hthouse/Robot_Getafix/media/roboeye1.gif

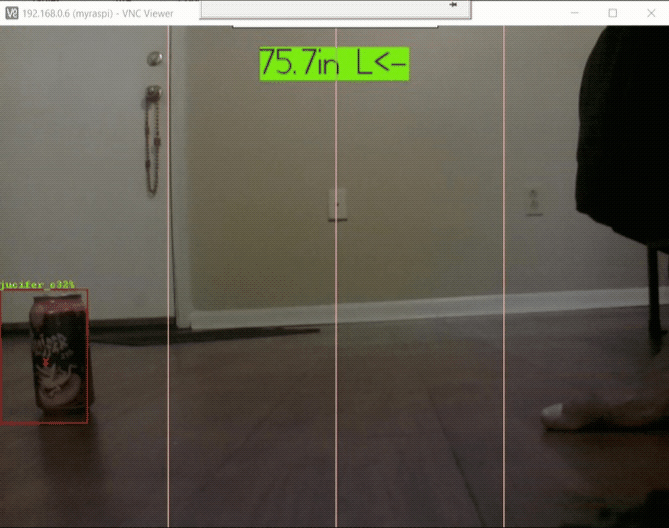
media/roboeye1.gif
