hthouse/Robot_Getafix/media/robopic1.jpg

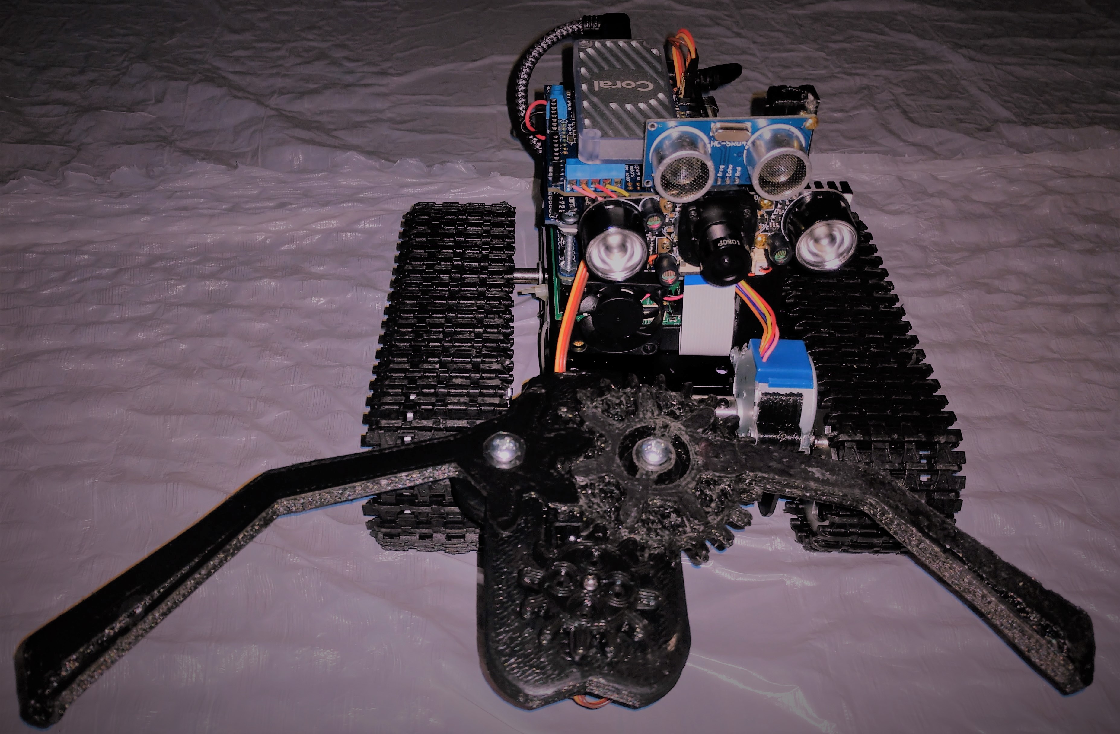
media/robopic1.jpg
