hthouse/Robot_Getafix/media/robopic2.jpg

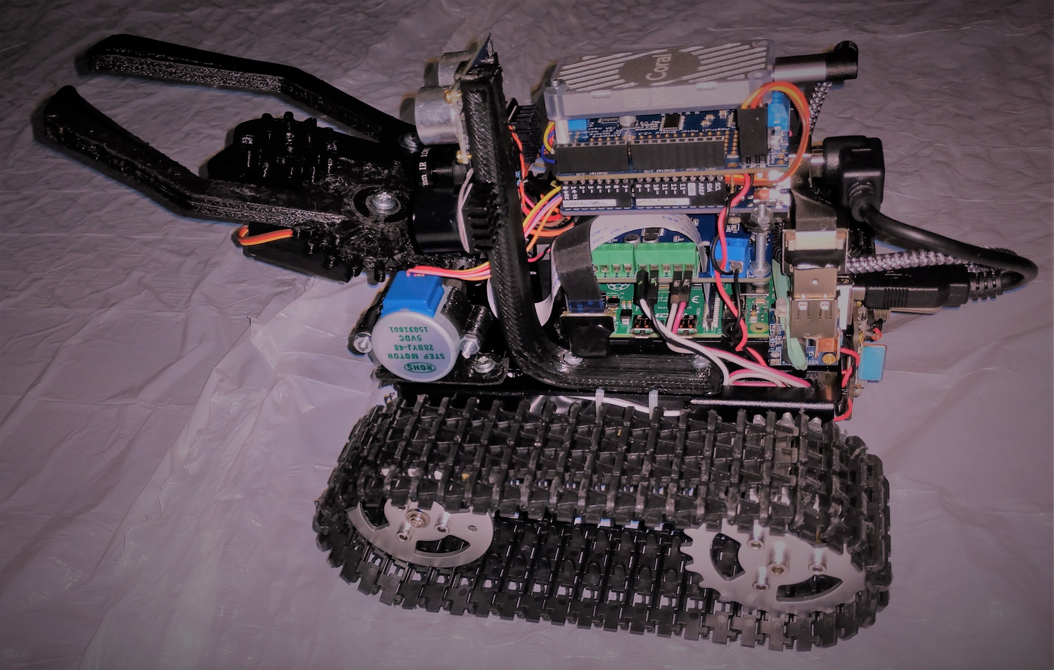
media/robopic2.jpg
